RiccardoEvangelisti/DeskSpy/README.md

# DeskSpy
DeskSpy is an Arduino-based project which helps the user to take a break every hour, using a OV7670 camera connected to a server via USB that implements facial recognition.
<br>
<p align="center">
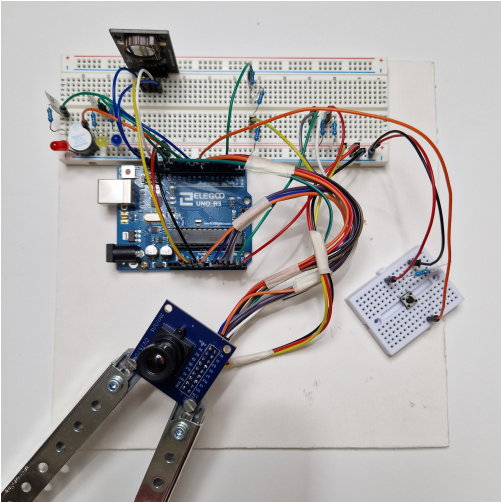
[picture p1: doc/pictures/DeskSpyPicture.png]
  
</p>

## Real Time Video Example
https://www.youtube.com/watch?v=nMDWoYeMBm0

## Circuit Diagrams
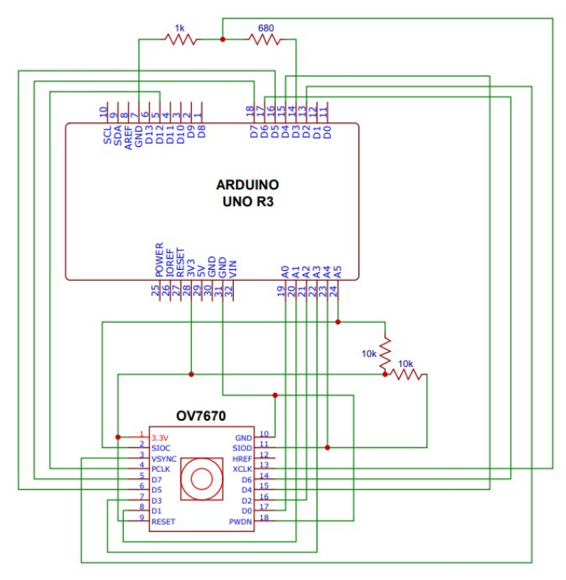
[picture p2: doc/pictures/CircuitDiagram1.png]

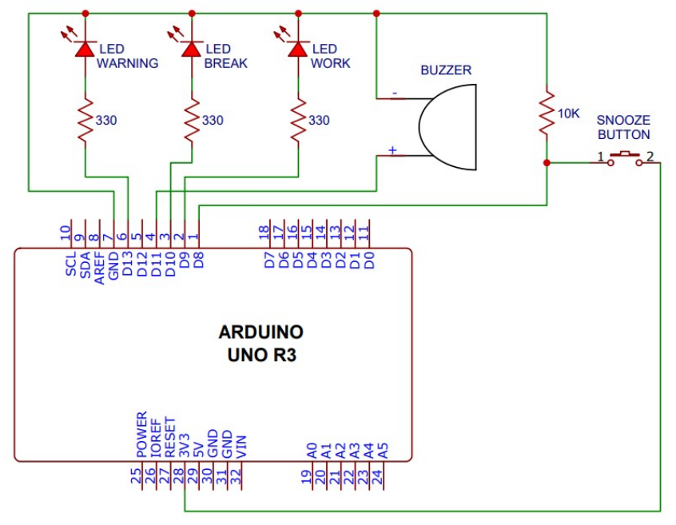
[picture p3: doc/pictures/CircuitDiagram2.png]
