RiccardoEvangelisti/DeskSpy/server/image_data/RiccardoEvangelisti/16_29_05.png

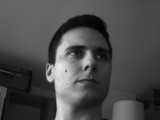
server/image_data/RiccardoEvangelisti/16_29_05.png
