RiccardoEvangelisti/DeskSpy/server/image_data/RiccardoEvangelisti/16_29_16.png

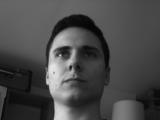
server/image_data/RiccardoEvangelisti/16_29_16.png
