RiccardoEvangelisti/DeskSpy/server/image_data/RiccardoEvangelisti/16_29_26.png

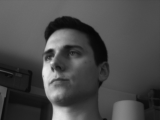
server/image_data/RiccardoEvangelisti/16_29_26.png
