RiccardoEvangelisti/DeskSpy/server/image_data/RiccardoEvangelisti/16_29_37.png

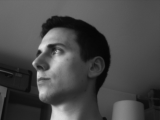
server/image_data/RiccardoEvangelisti/16_29_37.png
