RiccardoEvangelisti/DeskSpy/server/image_data/RiccardoEvangelisti/16_29_47.png

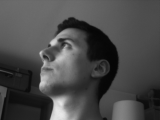
server/image_data/RiccardoEvangelisti/16_29_47.png
