RiccardoEvangelisti/DeskSpy/server/image_data/RiccardoEvangelisti/16_29_58.png

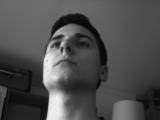
server/image_data/RiccardoEvangelisti/16_29_58.png
