RiccardoEvangelisti/DeskSpy/server/image_data/RiccardoEvangelisti/16_30_08.png

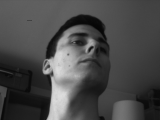
server/image_data/RiccardoEvangelisti/16_30_08.png
