RiccardoEvangelisti/DeskSpy/server/image_data/RiccardoEvangelisti/16_30_19.png

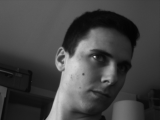
server/image_data/RiccardoEvangelisti/16_30_19.png
