RiccardoEvangelisti/DeskSpy/server/image_data/RiccardoEvangelisti/16_30_29.png

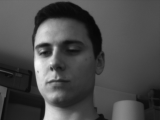
server/image_data/RiccardoEvangelisti/16_30_29.png
