RiccardoEvangelisti/DeskSpy/server/image_data/RiccardoEvangelisti/16_30_40.png

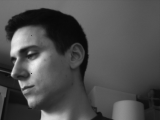
server/image_data/RiccardoEvangelisti/16_30_40.png
