RiccardoEvangelisti/DeskSpy/server/image_data/RiccardoEvangelisti/16_30_50.png

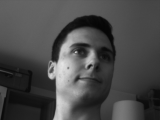
server/image_data/RiccardoEvangelisti/16_30_50.png
