RiccardoEvangelisti/DeskSpy/server/image_data/RiccardoEvangelisti/16_31_01.png

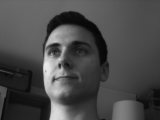
server/image_data/RiccardoEvangelisti/16_31_01.png
