RiccardoEvangelisti/DeskSpy/server/image_data/RiccardoEvangelisti/16_31_11.png

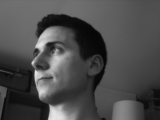
server/image_data/RiccardoEvangelisti/16_31_11.png
