RiccardoEvangelisti/DeskSpy/server/image_data/RiccardoEvangelisti/16_31_22.png

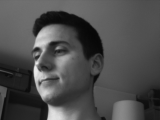
server/image_data/RiccardoEvangelisti/16_31_22.png
