RiccardoEvangelisti/DeskSpy/server/image_data/RiccardoEvangelisti/16_31_32.png

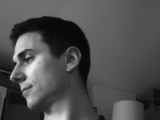
server/image_data/RiccardoEvangelisti/16_31_32.png
