RiccardoEvangelisti/DeskSpy/server/image_data/RiccardoEvangelisti/16_31_43.png

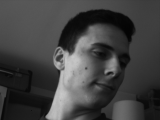
server/image_data/RiccardoEvangelisti/16_31_43.png
