RiccardoEvangelisti/DeskSpy/server/image_data/RiccardoEvangelisti/16_32_45.png

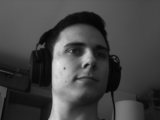
server/image_data/RiccardoEvangelisti/16_32_45.png
