RiccardoEvangelisti/DeskSpy/server/image_data/RiccardoEvangelisti/16_32_55.png

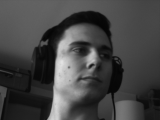
server/image_data/RiccardoEvangelisti/16_32_55.png
