RiccardoEvangelisti/DeskSpy/server/image_data/RiccardoEvangelisti/16_33_06.png

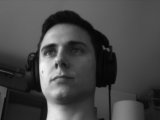
server/image_data/RiccardoEvangelisti/16_33_06.png
