RiccardoEvangelisti/DeskSpy/server/image_data/RiccardoEvangelisti/16_33_16.png

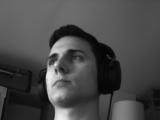
server/image_data/RiccardoEvangelisti/16_33_16.png
