RiccardoEvangelisti/DeskSpy/server/image_data/RiccardoEvangelisti/16_33_27.png

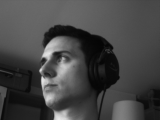
server/image_data/RiccardoEvangelisti/16_33_27.png
