RiccardoEvangelisti/DeskSpy/server/image_data/RiccardoEvangelisti/16_33_37.png

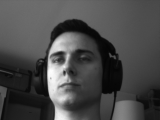
server/image_data/RiccardoEvangelisti/16_33_37.png
