RiccardoEvangelisti/DeskSpy/server/image_data/RiccardoEvangelisti/16_33_48.png

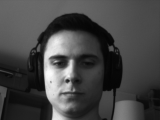
server/image_data/RiccardoEvangelisti/16_33_48.png
