RiccardoEvangelisti/DeskSpy/server/image_data/RiccardoEvangelisti/19_10_00.png

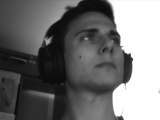
server/image_data/RiccardoEvangelisti/19_10_00.png
