RiccardoEvangelisti/DeskSpy/server/image_data/RiccardoEvangelisti/19_10_10.png

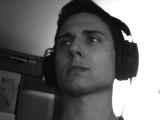
server/image_data/RiccardoEvangelisti/19_10_10.png
