RiccardoEvangelisti/DeskSpy/server/image_data/RiccardoEvangelisti/19_10_14.png

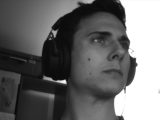
server/image_data/RiccardoEvangelisti/19_10_14.png
