RiccardoEvangelisti/DeskSpy/server/image_data/RiccardoEvangelisti/19_10_35.png

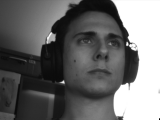
server/image_data/RiccardoEvangelisti/19_10_35.png
