RiccardoEvangelisti/DeskSpy/server/image_data/RiccardoEvangelisti/19_10_39.png

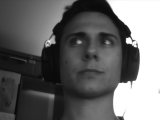
server/image_data/RiccardoEvangelisti/19_10_39.png
