RiccardoEvangelisti/DeskSpy/server/image_data/RiccardoEvangelisti/19_10_42.png

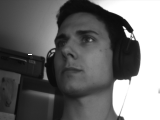
server/image_data/RiccardoEvangelisti/19_10_42.png
