RiccardoEvangelisti/DeskSpy/server/image_data/RiccardoEvangelisti/19_10_46.png

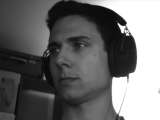
server/image_data/RiccardoEvangelisti/19_10_46.png
