RiccardoEvangelisti/DeskSpy/server/image_data/RiccardoEvangelisti/19_10_53.png

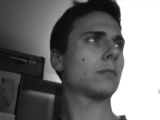
server/image_data/RiccardoEvangelisti/19_10_53.png
