RiccardoEvangelisti/DeskSpy/server/image_data/RiccardoEvangelisti/19_10_57.png

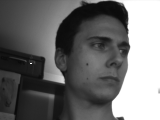
server/image_data/RiccardoEvangelisti/19_10_57.png
