RiccardoEvangelisti/DeskSpy/server/image_data/RiccardoEvangelisti/19_11_00.png

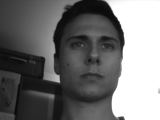
server/image_data/RiccardoEvangelisti/19_11_00.png
