RiccardoEvangelisti/DeskSpy/server/image_data/RiccardoEvangelisti/19_11_04.png

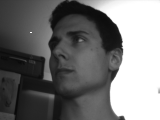
server/image_data/RiccardoEvangelisti/19_11_04.png
