RiccardoEvangelisti/DeskSpy/server/image_data/RiccardoEvangelisti/19_11_08.png

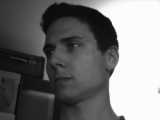
server/image_data/RiccardoEvangelisti/19_11_08.png
