RiccardoEvangelisti/DeskSpy/server/image_data/RiccardoEvangelisti/20_00_46.png

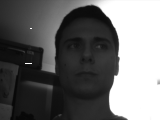
server/image_data/RiccardoEvangelisti/20_00_46.png
