RiccardoEvangelisti/DeskSpy/server/image_data/RiccardoEvangelisti/20_04_14.png

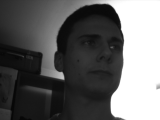
server/image_data/RiccardoEvangelisti/20_04_14.png
