RiccardoEvangelisti/DeskSpy/server/image_data/RiccardoEvangelisti/20_04_17.png

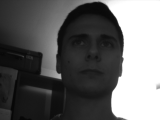
server/image_data/RiccardoEvangelisti/20_04_17.png
