RiccardoEvangelisti/DeskSpy/server/image_data/RiccardoEvangelisti/20_04_25.png

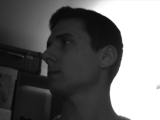
server/image_data/RiccardoEvangelisti/20_04_25.png
