RiccardoEvangelisti/DeskSpy/server/image_data/RiccardoEvangelisti/20_04_28.png

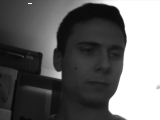
server/image_data/RiccardoEvangelisti/20_04_28.png
