RiccardoEvangelisti/DeskSpy/server/image_data/RiccardoEvangelisti/20_04_32.png

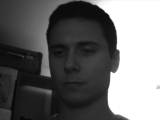
server/image_data/RiccardoEvangelisti/20_04_32.png
