RiccardoEvangelisti/DeskSpy/server/image_data/RiccardoEvangelisti/20_04_35.png

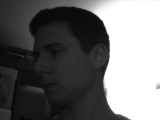
server/image_data/RiccardoEvangelisti/20_04_35.png
