RiccardoEvangelisti/DeskSpy/server/image_data/RiccardoEvangelisti/20_04_39.png

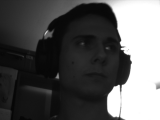
server/image_data/RiccardoEvangelisti/20_04_39.png
