RiccardoEvangelisti/DeskSpy/server/image_data/RiccardoEvangelisti/20_04_43.png

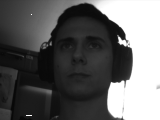
server/image_data/RiccardoEvangelisti/20_04_43.png
