RiccardoEvangelisti/DeskSpy/server/image_data/RiccardoEvangelisti/20_04_46.png

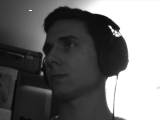
server/image_data/RiccardoEvangelisti/20_04_46.png
