RiccardoEvangelisti/DeskSpy/server/image_data/RiccardoEvangelisti/20_04_50.png

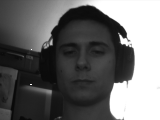
server/image_data/RiccardoEvangelisti/20_04_50.png
