RiccardoEvangelisti/DeskSpy/server/deskSpy.py

import serial
import logging
import numpy as np
from PIL import Image
import cv2
import pickle
import time
import signal
import os
import win32gui
import win32con
import win32api

# If the output prints are to be displayed in terminal
PRINT = True

# Enables the logger
LOGGER = True

# If the image is to be displayed when received
DISPLAY = False

# If the terminal and the camera display are TOPMOST over other windows
TOPMOST = True

# If the user's face is to be recognized or only detected
RECOGNITION = True

###################################################

WIDTH = 160
HEIGHT = 120

START_COMMAND = b"\x00"
RESET_COMMAND = b"1"
DETECTED_COMMAND = b"2"
RECOGNIZED_COMMAND = DETECTED_COMMAND
NOT_DETECTED_COMMAND = b"3"
NOT_RECOGNIZED_COMMAND = NOT_DETECTED_COMMAND
###################################################


def printTerminal(string):
    if PRINT:
        print(string)
        if LOGGER:
            logging.info(string)


def terminationHandler(signum, frame):
    ser.write(RESET_COMMAND)
    printTerminal("-- EXIT --")
    exit(1)


def getClock():
    return time.strftime("%H:%M:%S", time.localtime())


# Create and configure logger
logging.basicConfig(
    filename="log.log",
    format="%(message)s",
    encoding="utf-8",
    level=logging.DEBUG,
    filemode="w",
)

signal.signal(signal.SIGINT, terminationHandler)

hwnd = win32gui.GetForegroundWindow()
if PRINT:
    width = win32gui.GetWindowRect(hwnd)[2] - win32gui.GetWindowRect(hwnd)[0]
    height = win32gui.GetWindowRect(hwnd)[3] - win32gui.GetWindowRect(hwnd)[1]
    screen_width = win32api.GetSystemMetrics(0)
    screen_height = win32api.GetSystemMetrics(1)
    win32gui.SetWindowPos(
        hwnd,
        win32con.HWND_TOPMOST if TOPMOST else win32con.HWND_TOP,
        screen_width - width - 50,
        100,
        width,
        height,
        0,
    )
    os.system("title DeskSpy")
    os.system("mode con: cols=30 lines=10")
    printTerminal("-- START --")
else:
    win32gui.ShowWindow(hwnd, win32con.SW_HIDE)

# Open serial connection
ser = serial.Serial(
    "COM5",
    1000000,
    timeout=None,
    parity=serial.PARITY_NONE,
    stopbits=serial.STOPBITS_ONE,
    bytesize=serial.EIGHTBITS,
)

# Detect faces
face_detector = cv2.CascadeClassifier("haarcascade_frontalface_default.xml")

# Recognize faces from trained data
face_recognizer = cv2.face.LBPHFaceRecognizer_create()
face_recognizer.read("trainer.yml")

# Create dictionary{ID,name} for every person
labels = {}
with open("labels.pickle", "rb") as f:
    og_label = pickle.load(f)
    labels = {v: k for k, v in og_label.items()}

# Local buffer
buffer = bytearray()
result = b"-1"
ID = ""

# Wait the Syn from the client
while ser.read(1) != b"s":
    pass
# Send the Ack
ser.write(b"a")

printTerminal("-- SYNCED --")

# Read first byte
byte = ser.read(1)
# Cler the UDR0 buffer from previuos readings
while byte != START_COMMAND:
    byte = ser.read(1)

while True:
    if byte == START_COMMAND:
        # Clear the buffer
        ser.reset_output_buffer()
        buffer = bytearray()
        result = b"-1"
        # Read one frame
        for i in range(WIDTH * HEIGHT):
            byte = ser.read(1)
            buffer.append(int.from_bytes(byte, byteorder="big"))
        # Reshape buffer into array[HEIGHT][WIDTH]
        img_array = np.array(buffer).reshape(HEIGHT, WIDTH)
        # Convert the array to a grayscale image
        img_array = np.array(Image.fromarray(img_array, "L"))
        if DISPLAY:
            cv2.namedWindow("camera", cv2.WINDOW_NORMAL)
            if TOPMOST:
                cv2.setWindowProperty("camera", cv2.WND_PROP_TOPMOST, 1)
            cv2.imshow("camera", img_array)
            cv2.waitKey(1)
        # Detect faces
        faces = face_detector.detectMultiScale(
            img_array, scaleFactor=1.05, minNeighbors=3
        )
        clock = getClock()
        if len(faces) > 0:
            if RECOGNITION:
                # Recognize the faces in trained data
                recognized = False
                for (x, y, w, h) in faces:
                    ID, conf = face_recognizer.predict(img_array[y : y + h, x : x + w])
                    if conf >= 20 and conf <= 115:
                        recognized = True
                        break
                if recognized:
                    printTerminal(clock + " Face recognized, ID: " + labels[ID])
                    result = RECOGNIZED_COMMAND
                else:
                    printTerminal(clock + " Face not recognized")
                    result = NOT_RECOGNIZED_COMMAND
            else:
                printTerminal(clock + " Face detected")
                result = DETECTED_COMMAND
        else:
            printTerminal(clock + " No face detected")
            result = NOT_DETECTED_COMMAND
        ser.write(result)
    # Read next byte
    byte = ser.read(1)
    while byte == b'':
        printTerminal(getClock() + " SERVER TIMEOUT: resending...")
        ser.write(result)
        byte = ser.read(1)
