RiccardoEvangelisti/DeskSpy/arduino/DeskSpy/CameraOV7670Registers.cpp

#include "CameraOV7670Registers.h"

CameraOV7670Registers::CameraOV7670Registers(const uint8_t i2cAddress) : i2cAddress(i2cAddress) {
}

void CameraOV7670Registers::init() {
  Wire.begin();
}

bool CameraOV7670Registers::resetSettings() {
  bool isSuccessful = setRegister(REG_COM7, COM7_RESET);
  delay(500);
  return isSuccessful;
}

void CameraOV7670Registers::setRegisters(const RegisterData *programMemPointer) {
  while (true) {
    RegisterData regData = {
        addr: pgm_read_byte(&(programMemPointer->addr)),
        val: pgm_read_byte(&(programMemPointer->val))
    };
    if (regData.addr == 0xFF) {
      break;
    } else {
      setRegister(regData.addr, regData.val);
      programMemPointer++;
    }
  }
}

bool CameraOV7670Registers::setRegister(uint8_t addr, uint8_t val) {
  Wire.beginTransmission(i2cAddress);
  Wire.write(addr);
  Wire.write(val);
  return Wire.endTransmission() == 0;
}


uint8_t CameraOV7670Registers::readRegister(uint8_t addr) {
  Wire.beginTransmission(i2cAddress);
  Wire.write(addr);
  Wire.endTransmission();

  Wire.requestFrom(i2cAddress, (uint8_t)1);
  return Wire.read();
}

void CameraOV7670Registers::setRegisterBitsOR(uint8_t addr, uint8_t bits) {
  uint8_t val = readRegister(addr);
  setRegister(addr, val | bits);
}

void CameraOV7670Registers::setDisablePixelClockDuringBlankLines() {
  setRegisterBitsOR(REG_COM10, COM10_PCLK_HB);
}

void CameraOV7670Registers::setDisableHREFDuringBlankLines() {
  setRegisterBitsOR(REG_COM6, COM6_HREF_HB);
}

void CameraOV7670Registers::setInternalClockPreScaler(int preScaler) {
  setRegister(REG_CLKRC, 0x80 | preScaler); // f = input / (val + 1)
}

void CameraOV7670Registers::setPLLMultiplier(uint8_t multiplier) {
  uint8_t mask = 0b11000000;
  uint8_t currentValue = readRegister(DBLV);
  setRegister(DBLV, (currentValue & ~mask) | (multiplier << 6));
}
