RiccardoEvangelisti/DeskSpy/(commit log)

2023-02-03 Fix type conversion bug
    [DeskSpy.ino, DeskSpyDefinitions.cpp, DeskSpyDefinitions.h]
2023-02-17 Update DeskSpy.ino
    Fix types
    [DeskSpy.ino]
2023-03-05 Fixed read() blocking bug
    [DeskSpy.ino, DeskSpyDefinitions.cpp, DeskSpyDefinitions.h, deskSpy.py, deskSpy_savePictures.py]
2023-03-07 Trying to fix random blocking
    [deskSpy.py]
2023-03-07 Trying to fix RTC bug
    [DeskSpy.ino, DeskSpyDefinitions.cpp, DeskSpyDefinitions.h]
